Alexa-Academy/ALEX80/Schematic_Z80-PCB_v1.0.png

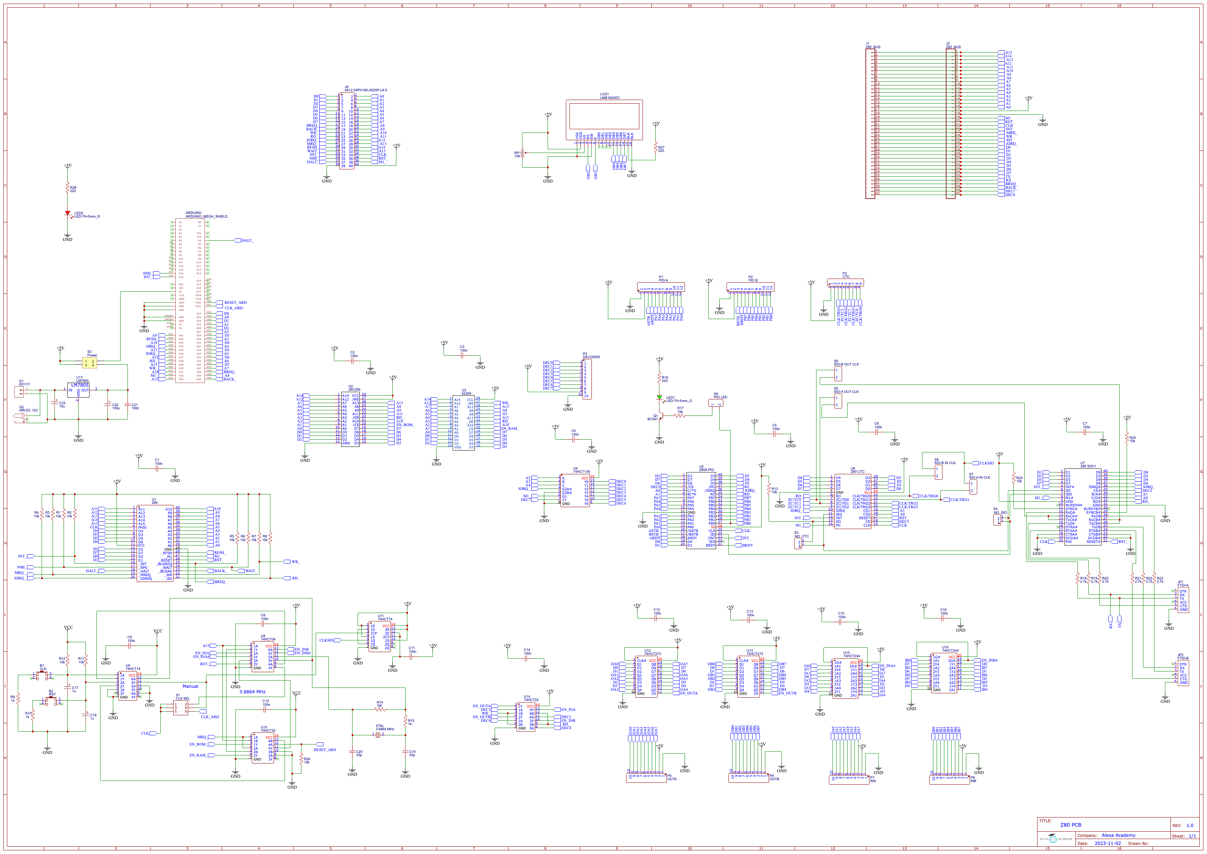
Schematic_Z80-PCB_v1.0.png
